tivanis/MicroInverter/Project Outputs for MicroInverter/MicroInverter_BOM.xls

Comment | Description | Designator | Footprint | LibRef | Manufacturer Part Number | Quantity
4u7F, 25V | Capacitor | C1, C2, C3, C27, C28 | 0805 | Cap Semi | 885012107018 | 5
100pF | 885012006036 | C4, C6, C7, C8 | 0603 | Cap Semi | GCM0335C1E101GA16D | 4
100nF, 50V | Capacitor | C5, C9, C10, C17, C18, C19, C20, C23, C24, C26 | 0603 | Cap Semi | C0603C104M5RACTU | 10
82uF, 63V | Capacitor Polarized | C11, C14 | CAP_H10 | Cap Pol | HHXC630ARA820MJA0G | 2
10uF, 63V | Capacitor | C12, C13, C15, C16 | 1210 | Cap Semi | GRM32ER71J106KA12L | 4
47nF, 100V | Capacitor | C21 | 0805 | Cap Semi | CC0805KKX7R0BB473 | 1
1uF, 25V | Capacitor | C22, C25, C29 | 0805 | Cap Semi | VJ0805Y105KXXTW1BC | 3
1uF, 100V | Capacitor | C30, C31 | 0805 | Cap Semi | HMK212BBJ105KG-TE | 2
BAT54S-TP |  | D1, D2, D3, D4 | SOT 23 | BAT54S-TP | BAT54S-TP | 4
RB168MM100TFTR |  | D5 | SOD123 | Diode | RB168MM100TFTR | 1
LED GRN | Typical RED, GREEN, YELLOW, AMBER GaAs LED | DS1 | 0805LED | LED | LTST-S220GKT | 1
CON 3 |  | J1 | CON 3 MOLEX SL | CON 3 SIL Angle | 70553-0002 | 1
CON 6 |  | J2 | CON 6 MOLEX SL | CON 6 SIL Angle | 70553-0040 | 1
CON 10X2 |  | J3, J4 | CON 20 HEADER - (ALT) | CON 10X2 | 68683-305LF | 2
 |  | J5, J6, J7, J8, J9 | CON 1 M3 SCREW | CON 1 Hi Power_Small | Keystone 7771 | 5
6.8uH, 1.6A | Magnetic-Core Inductor | L1 | INDUCTOR - 4x4 mm | Inductor Iron | TYS40306R8M-10 | 1
N-FET |  | Q1, Q2, Q3, Q4, Q5, Q6 | SO-8FL | N-FET | NVMFS6H800NT1G | 6
470k | CR0805-JW-680ELF | R1 | 0805 | Res | CR0805-FX-4703ELF | 1
20k | CR0805-JW-680ELF | R2 | 0805 | Res | CR0805-FX-2002ELF | 1
18k | CR0805-JW-680ELF | R3 | 0805 | Res | CR0805-FX-1802ELF | 1
150Ohm | CR0805-JW-680ELF | R4 | 0805 | Res | CR0805-JW-151ELF | 1
4.7k | CR0805-JW-680ELF | R5, R17, R18, R21 | 0805 | Res | CR0805-FX-4701ELF | 4
2k | CR0805-JW-680ELF | R6, R14, R15, R16, R25 | 0805 | Res | CR0805-FX-2001ELF | 5
3.3k | CR0805-JW-680ELF | R7, R8, R9, R10 | 0805 | Res | CR0805-FX-3301ELF | 4
13k, 1% | CR0805-JW-680ELF | R11, R12, R13 | 0805 | Res | CR0805-FX-1302ELF | 3
200k, 1% | CR0805-JW-680ELF | R19, R20, R26 | 0805 | Res | CR0805-FX-2003ELF | 3
13.3k, 1% | CR0805-JW-680ELF | R22, R23, R24 | 0805 | Res | CR0805-FX-1332ELF | 3
1mOhm | Resistor | R27, R28, R29 | RES TLR2HW CURRENT SENSE | Res | TLR2HWDTE1L00F50 | 3
44.2k, 1% | Resistor | R30, R31, R32, R33 | 0805 | Res | CR0805-FX-4422ELF | 4
39Ohm | Resistor | R34, R35, R36, R37 | 0805 | Res | CR0805-JW-390ELF | 4
2.4k, 1% | Resistor | R38, R39, R40, R41 | 0805 | Res | CR0805-FX-2401ELF | 4
3Ohm | Resistor | R42, R44, R46, R48, R50, R54 | 0805 | Res | SG73P2ATTD3R00F | 6
0Ohm | Resistor | R43, R45, R47, R49, R51 | 0805 | Res | CR0805-J/-000ELF | 5
18kOhm | Resistor | R52, R53 | 0805 | Res | CR0805-FX-1802ELF | 2
1MOhm | Resistor | R55, R56 | 0805 | Res | CR0805-FW-1005ELF | 2
100k | Resistor | R57 | 0805 | Res | CR0805-FX-1003ELF | 1
54.9k, 1% | Resistor | R58 | 0805 | Res | CR0805-FX-5492ELF | 1
10k, 1% | Resistor | R59 | 0805 | Res | CR0805-FX-1003ELF | 1
TC2117-3.3V | Linear regulator | U1 | SOT223 (ZLDO) | 1117 | TC2117-3.3VDBTR | 1
MCP6V26 |  | U2 | SOIC 8-pin | OP_AMP_SINGLE_SOIC | MCP6V26-E/MS | 1
TLC374CDR | Comparator, quad, open drain | U3 | SOIC14 | Comparator Quad | TLC374CDR | 1
INA240 |  | U4, U6 | SOIC 8-pin | INA240 | INA240A2DR | 2
DRV8320RHRHAR | 3f Gate driver 60V | U5 | VQFN-40 | DRV8320RHRHAR | DRV8320RHRHAR | 1
