tivanis/MicroInverter/PDF Schematics and Layout/MicroInverter_Design_Files.pdf

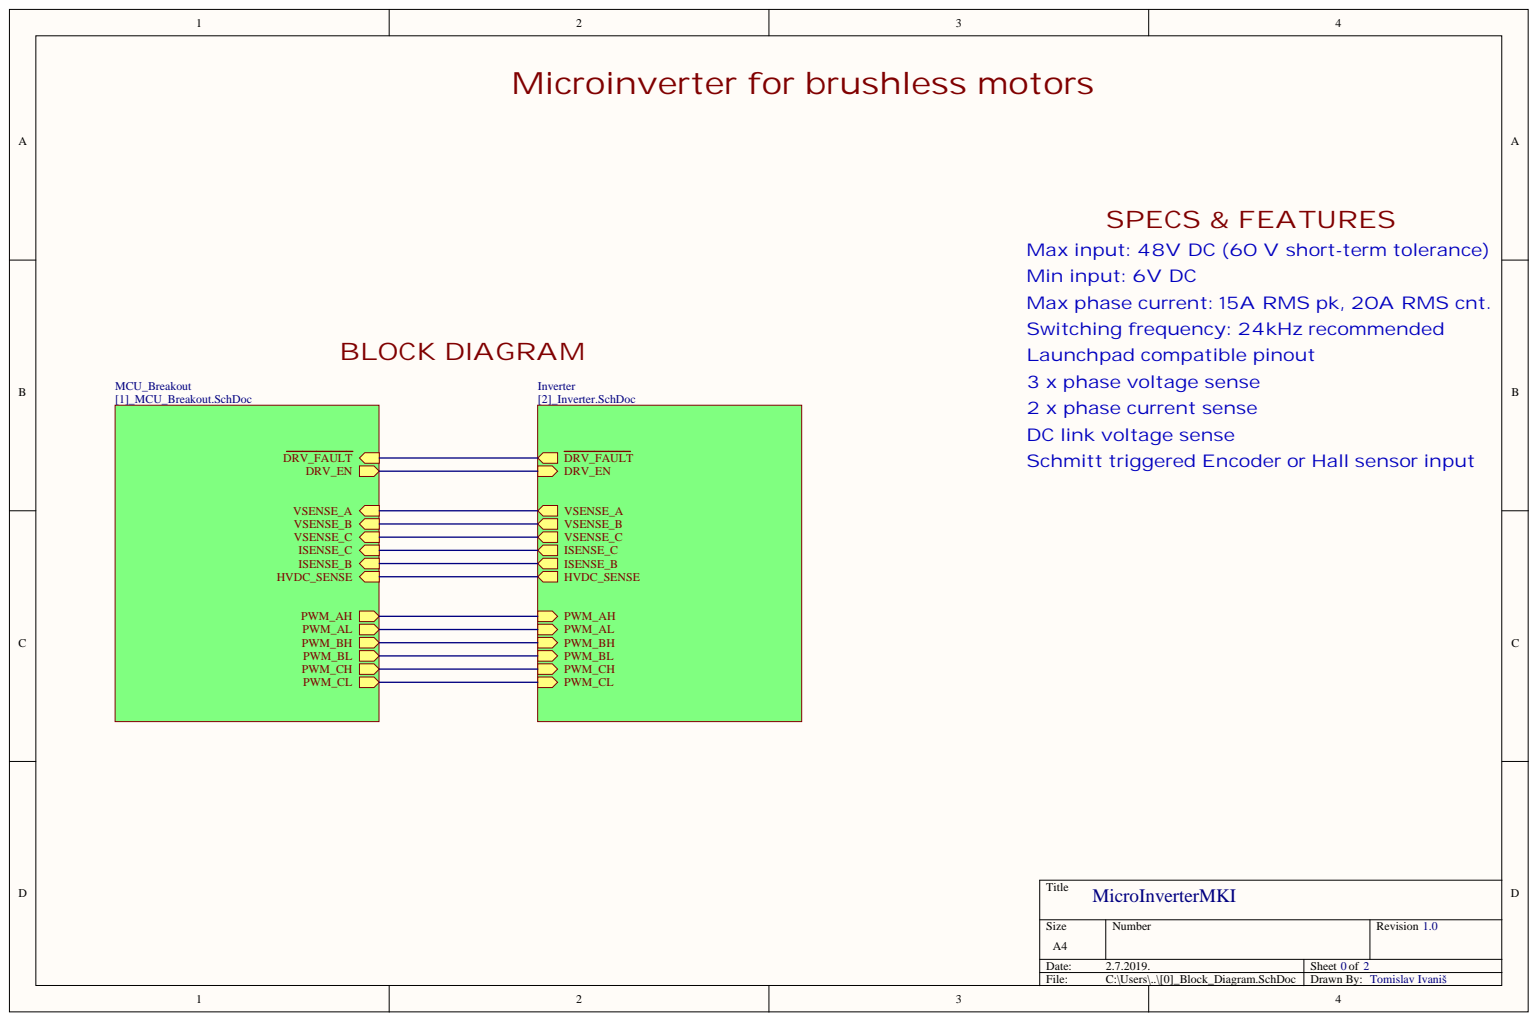
[picture p1: page 1]

Microinverter for brushless motors

Max input: 48V DC (60 V short-term tolerance)
Min input: 6V DC
Max phase current: 15A RMS pk, 20A RMS cnt.
Switching frequency: 24kHz recommended

3 x phase voltage sense
2 x phase current sense
DC link voltage sense
Schmitt triggered Encoder or Hall sensor input

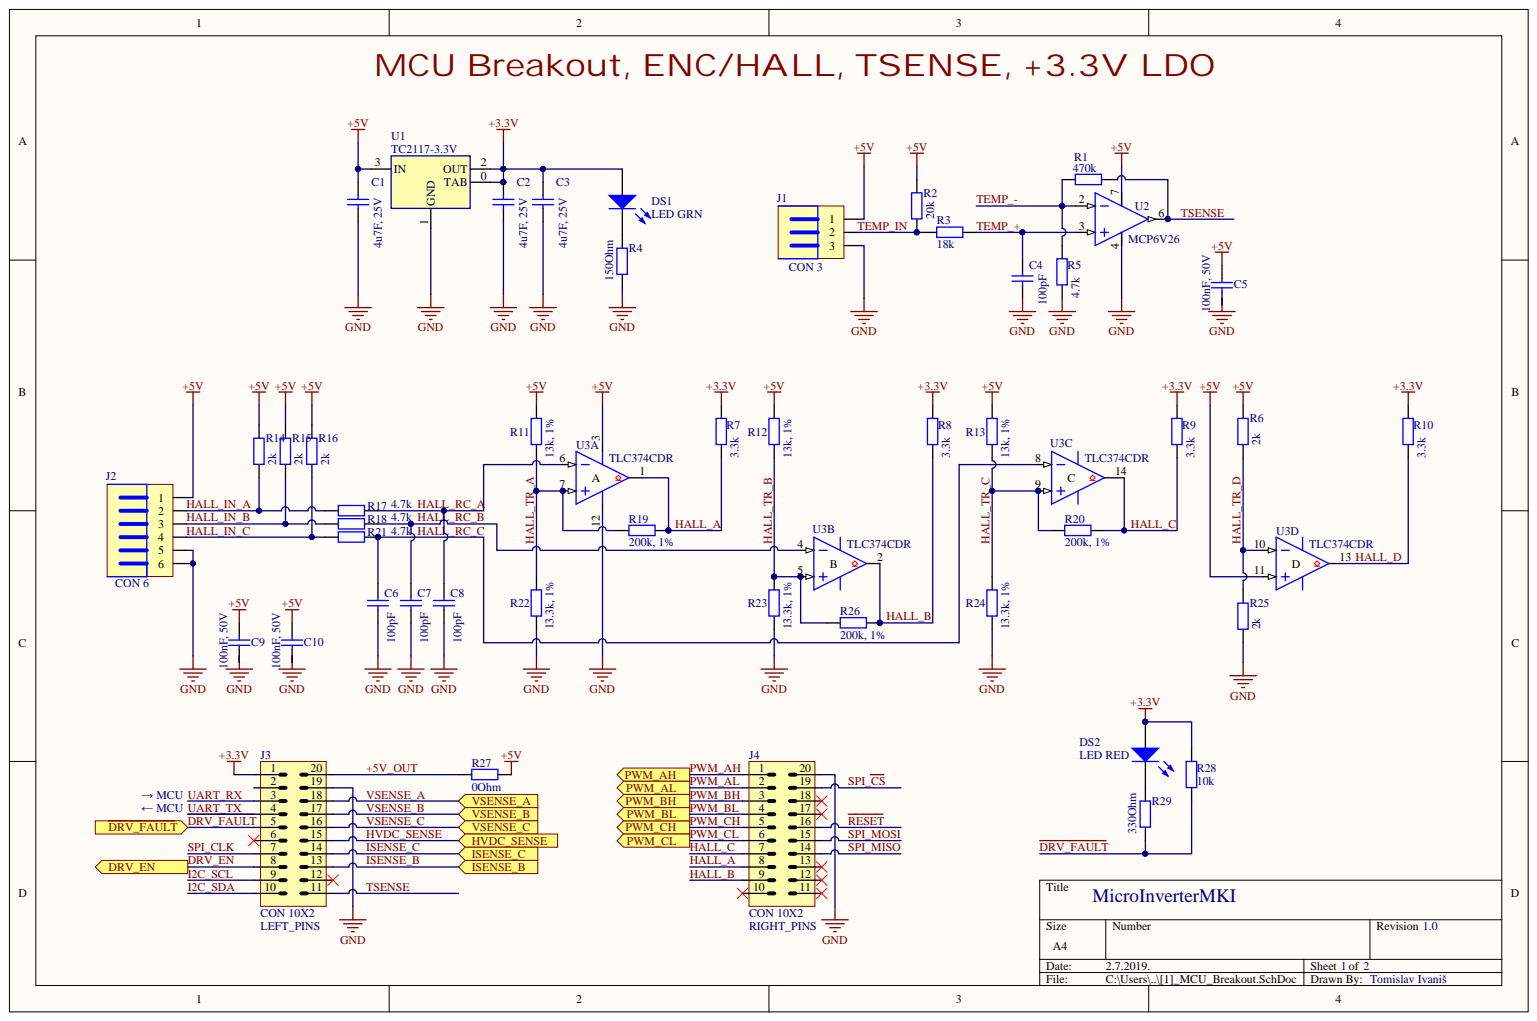
[picture p2: page 2]

MCU Breakout, ENC/HALL, TSENSE, +3.3V LDO

HALL_IN_B | | R18 4.7k HALL_RC_B
HALL_IN_C | R21 4.7k

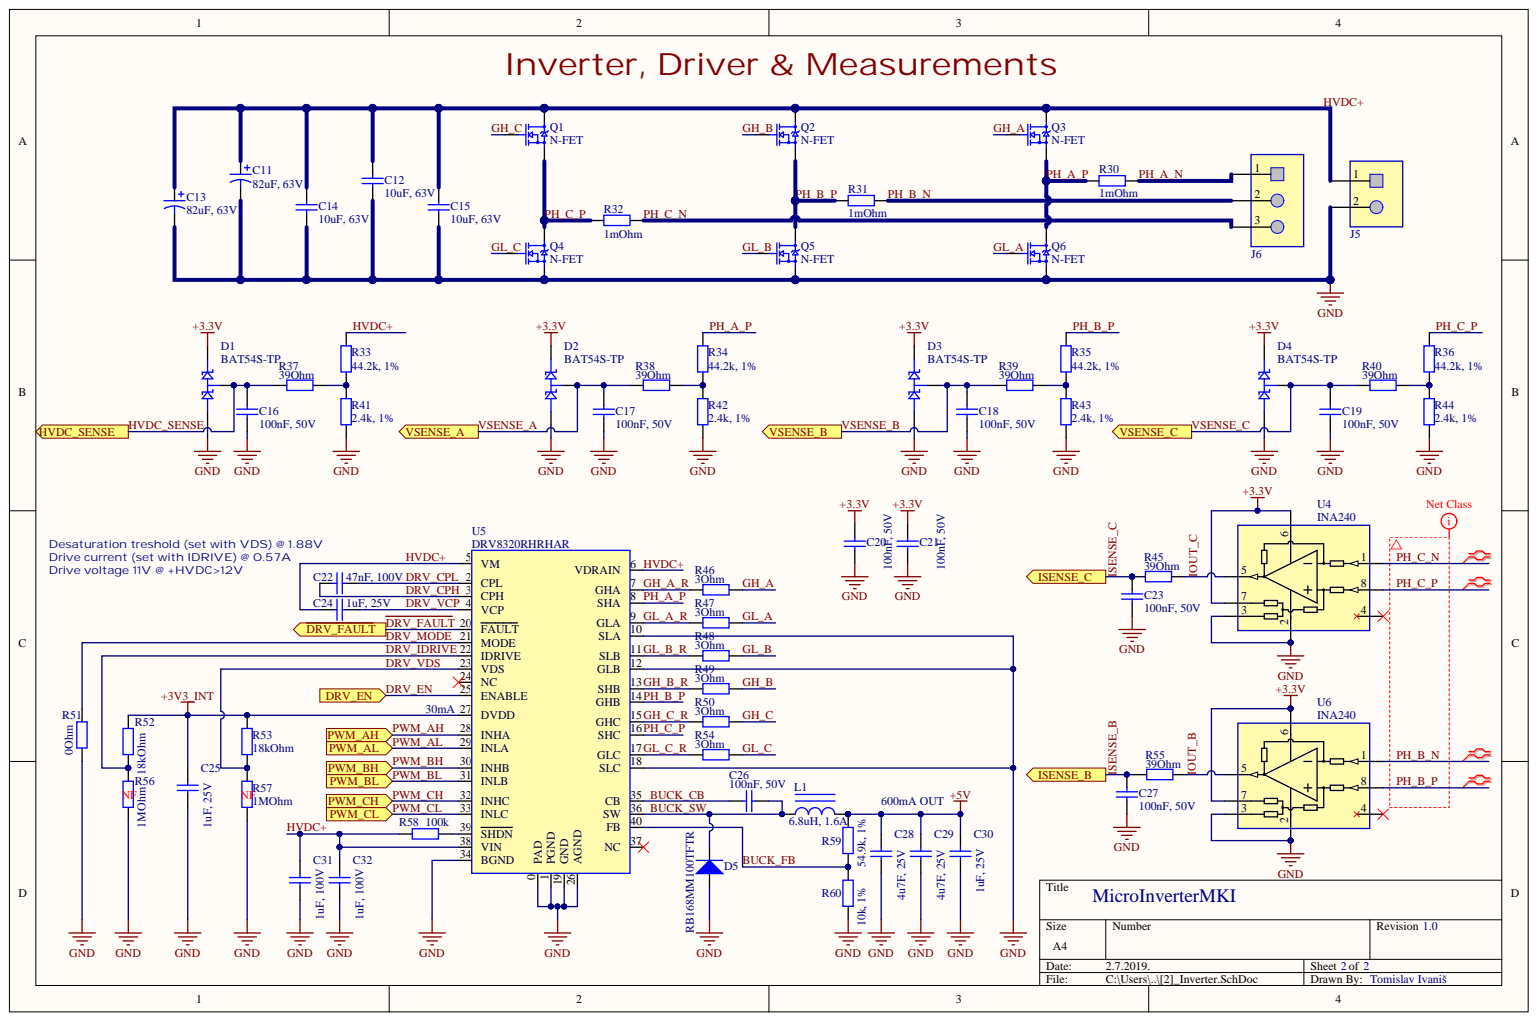
[picture p3: page 3]

Desaturation treshold (set with VDS) @ 1.88V
Drive current (set with IDRIVE) @ 0.57A
Drive voltage 11V @ +HVDC>12V

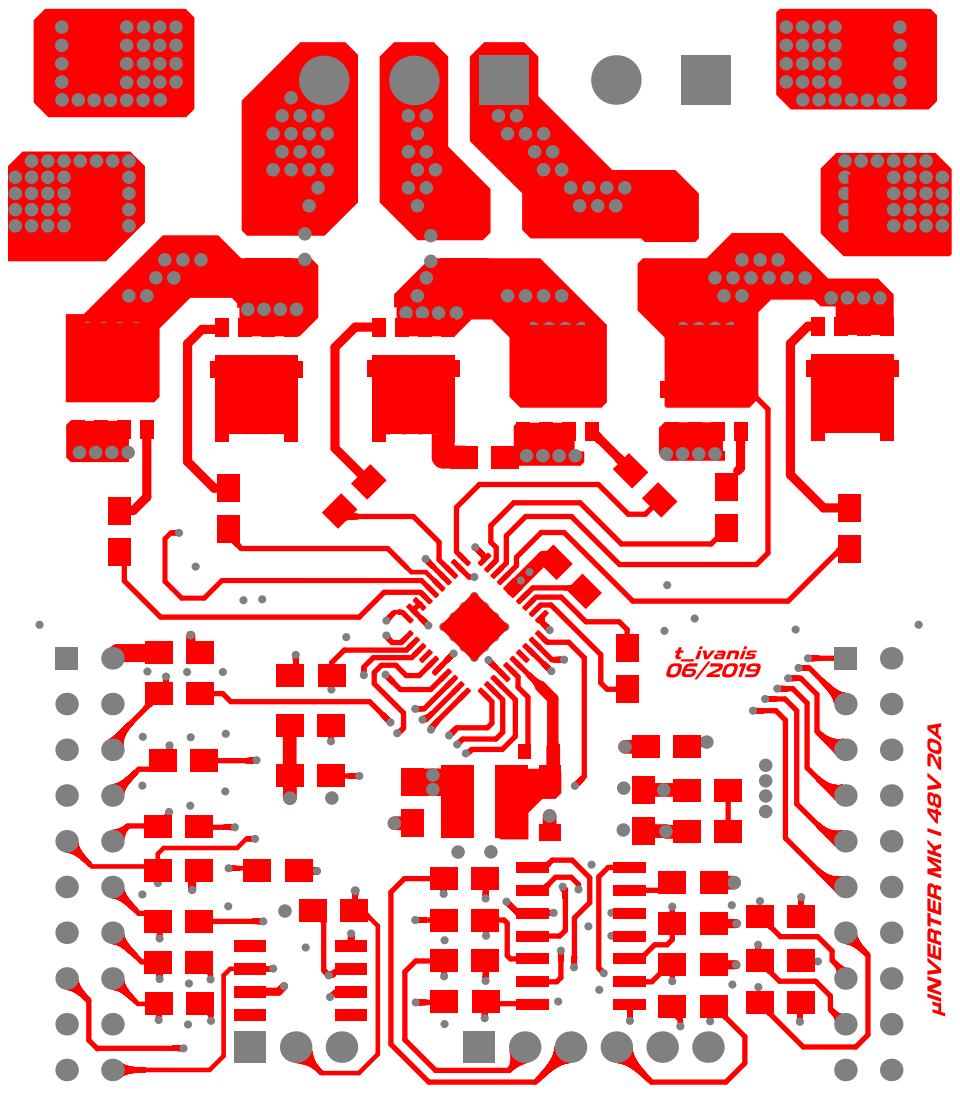
[picture p4: page 4]

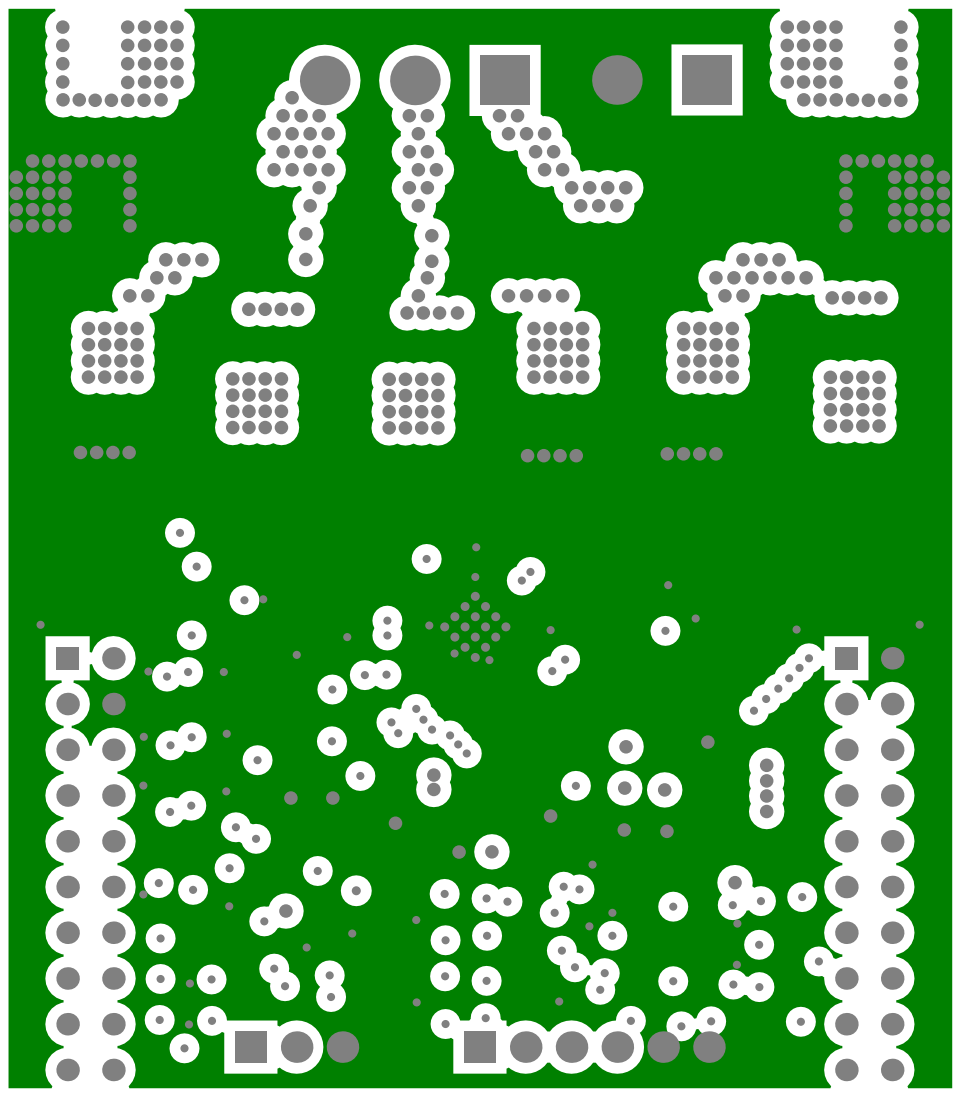
[picture p5: page 5]

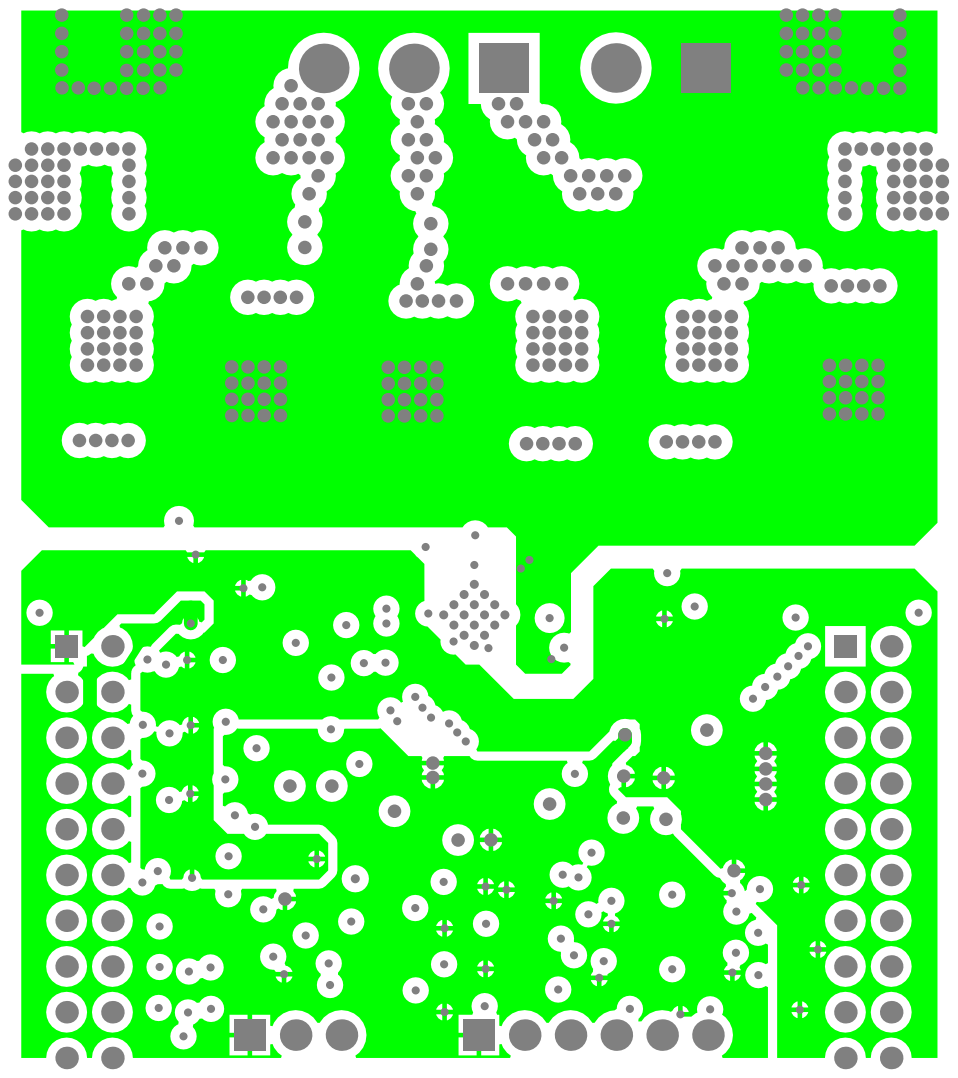
[picture p6: page 6]

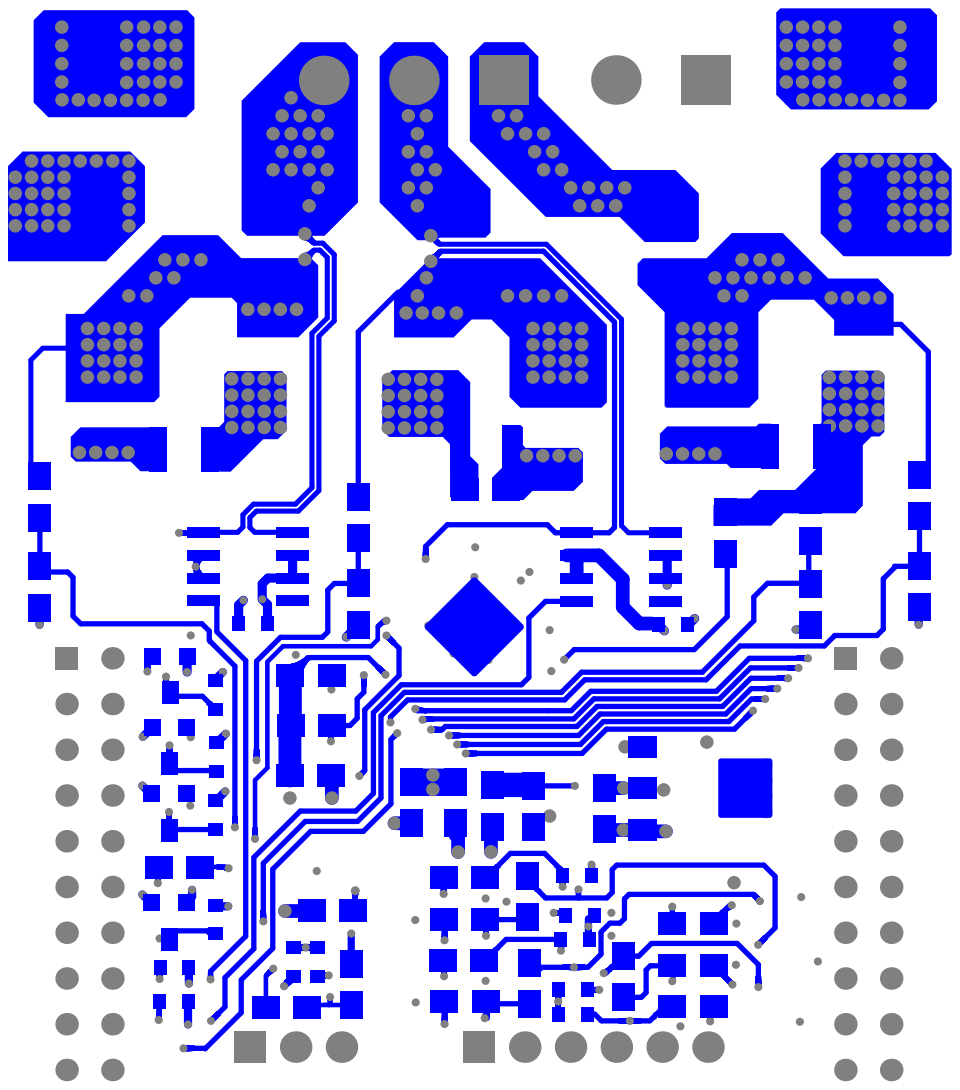
[picture p7: page 7]

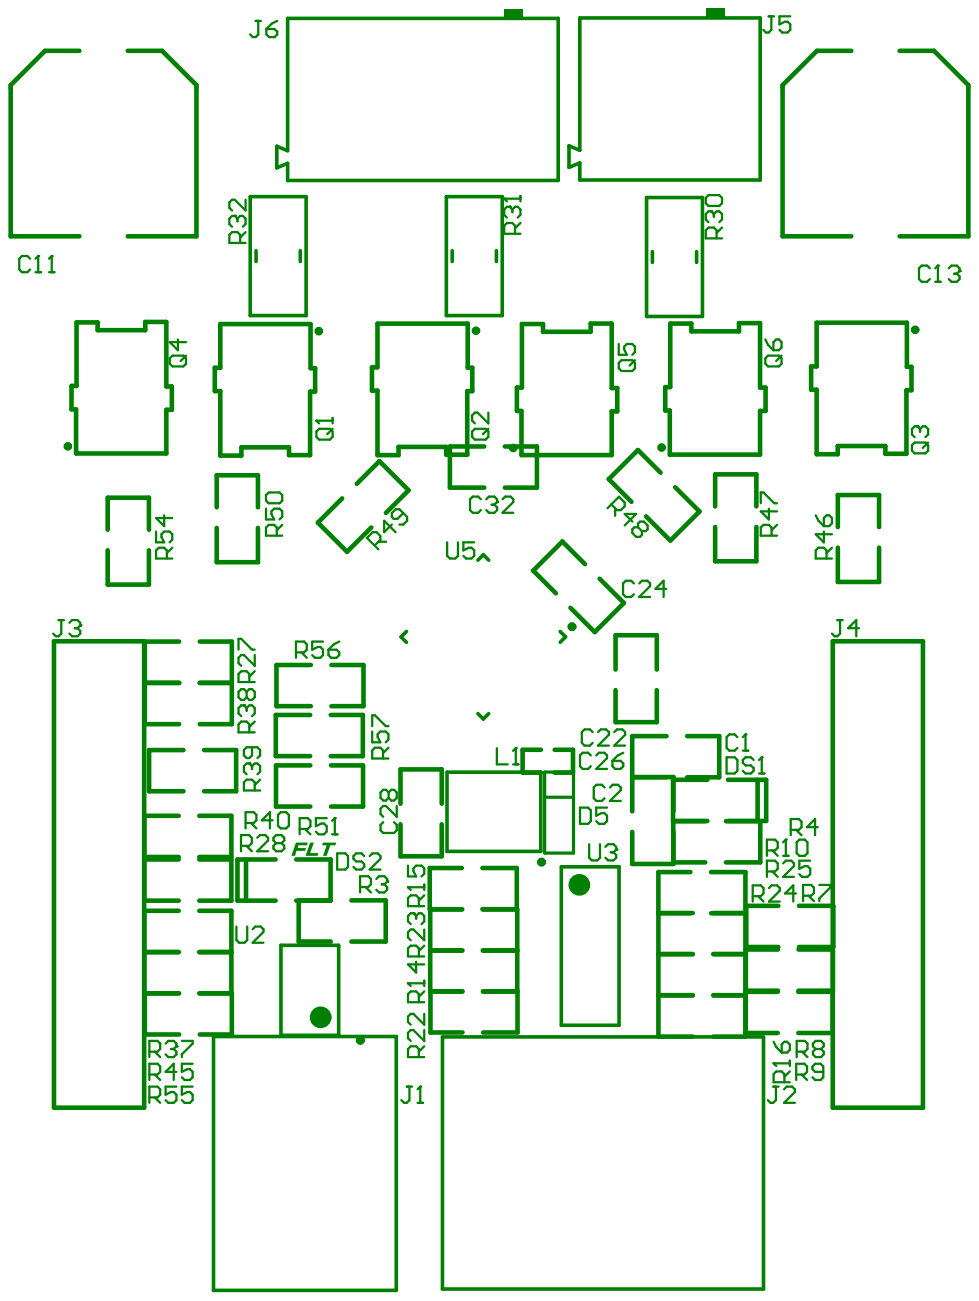
[picture p8: page 8]

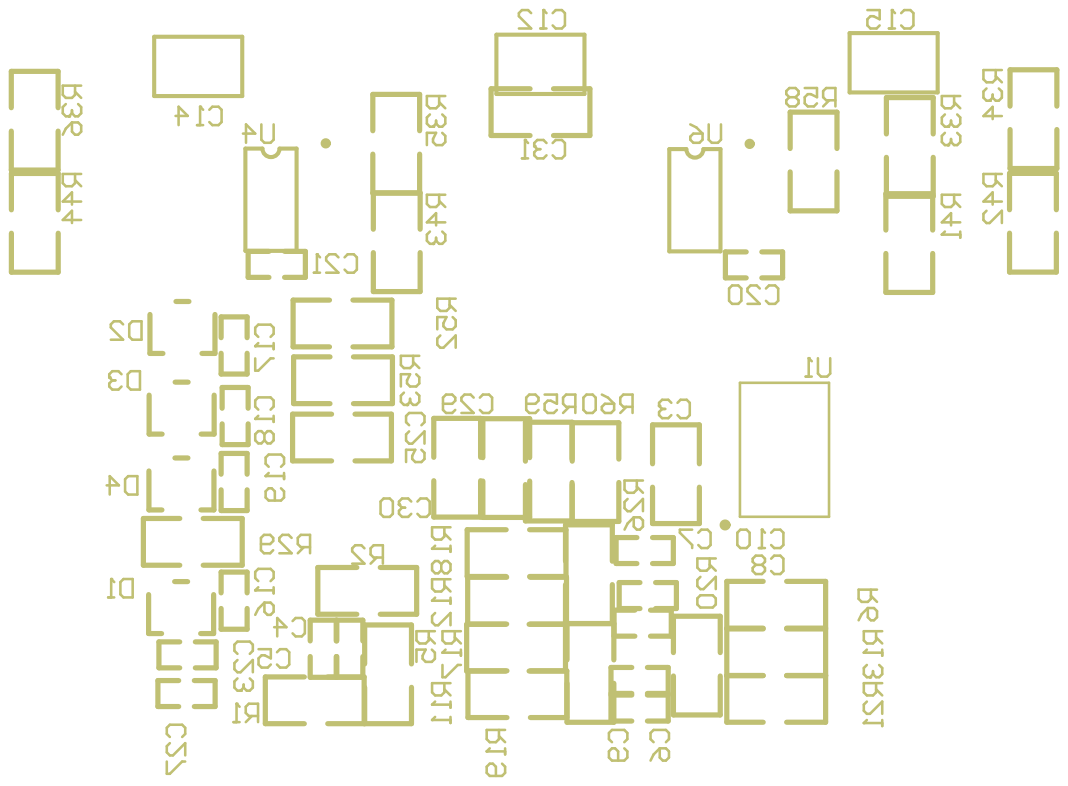
[picture p9: page 9]

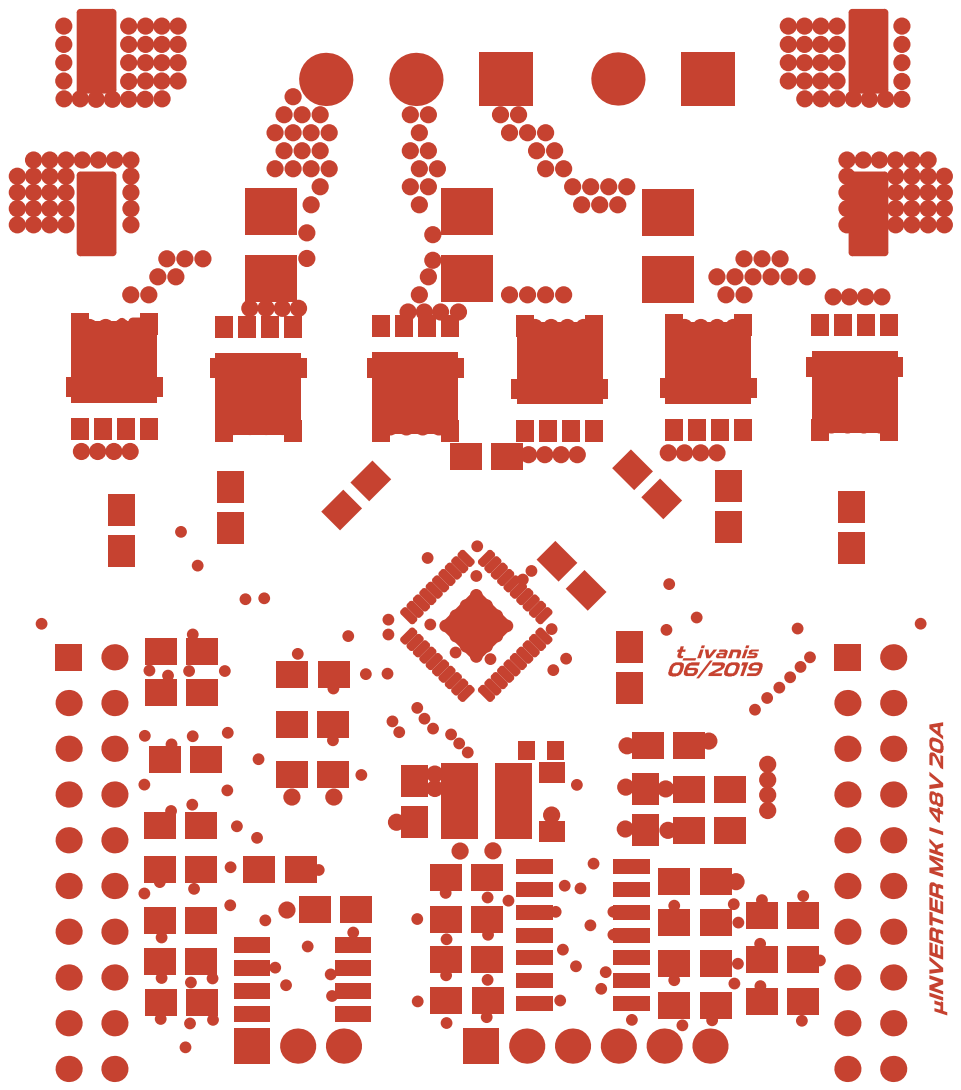
[picture p10: page 12]

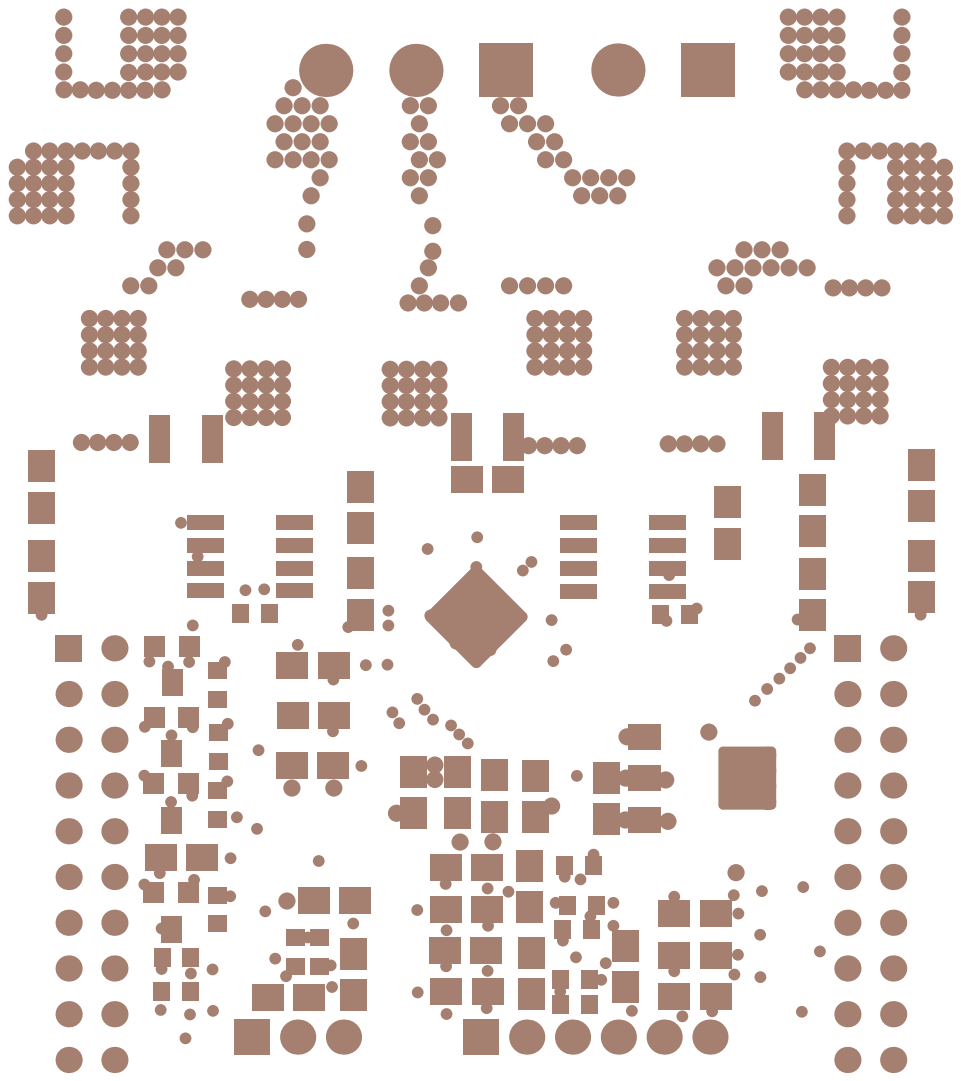
[picture p11: page 13]

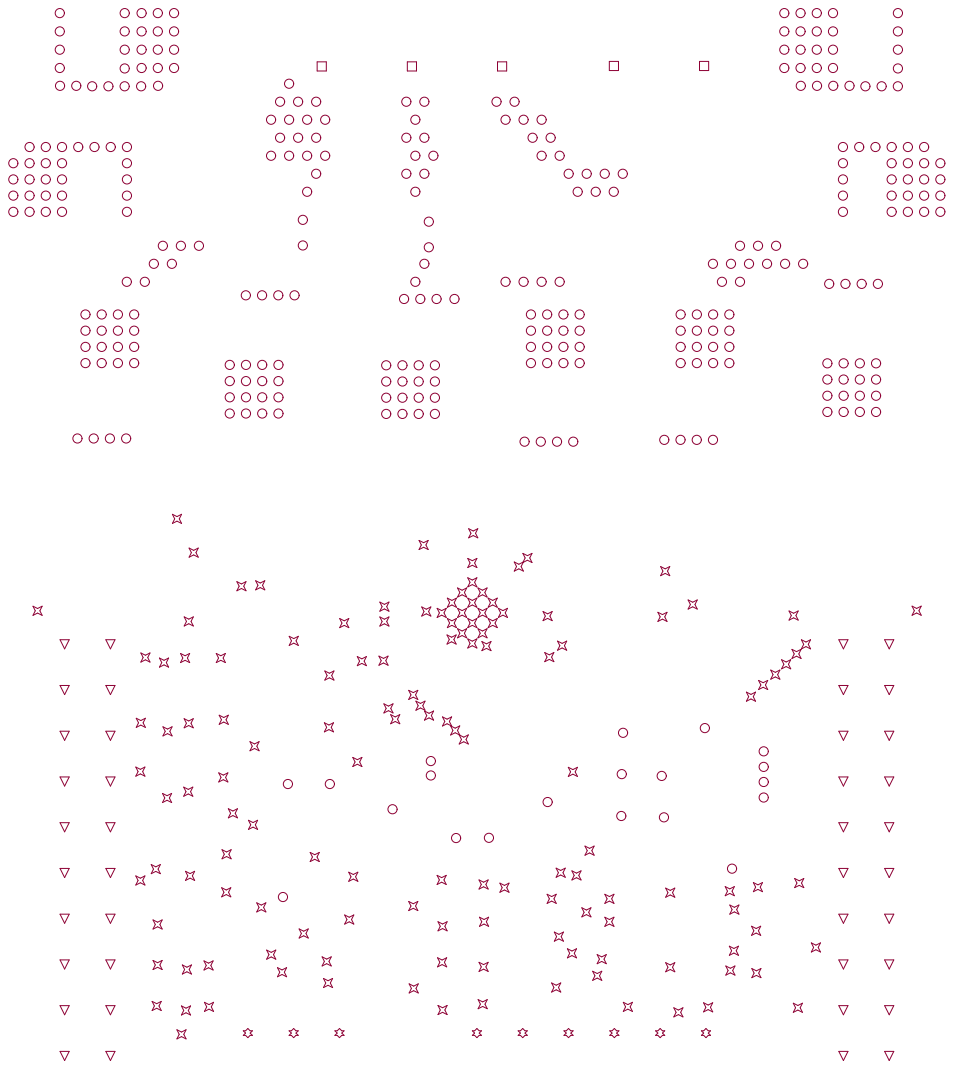
[picture p12: page 19]

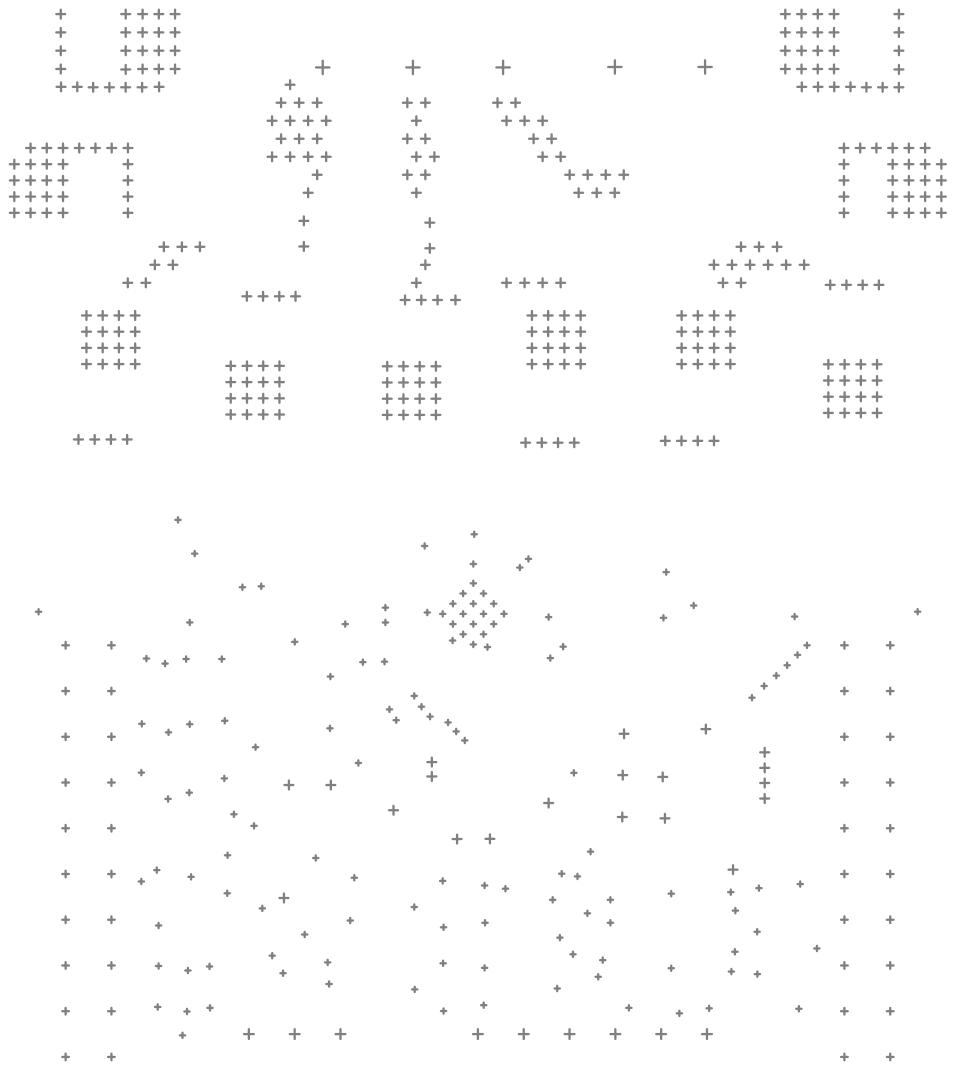
[picture p13: page 20]
