tivanis/MicroInverter/(list of files, drawings)

Other design files:
[0]_Block_Diagram.SchDoc
[1]_MCU_Breakout.SchDoc
[2]_Inverter.SchDoc
MicroInverter.PrjPcb
