tivanis/MicroInverter/(commit log)

2019-06-30 Initial complete project commit
    [MicroInverter.PrjPcb, MicroInverter_BOM.xls, [0]_Block_Diagram.SchDoc, [1]_MCU_Breakout.SchDoc, [2]_Inverter.SchDoc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]
2019-07-01 Fixed schematic titles and pdf output
    [MicroInverter.PrjPcb, [0]_Block_Diagram.SchDoc, [1]_MCU_Breakout.SchDoc, [2]_Inverter.SchDoc]
2019-07-01 Updated gerber and drill files
    [MicroInverter.PrjPcb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]
2019-07-01 Fixed top overlay
    [MicroInverter.PrjPcb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]
2019-07-01 Overlay hotfix
    [uInv_PCB.GBL, uInv_PCB.GBO, uInv_PCB.GBS, uInv_PCB.GM1, uInv_PCB.GTL, uInv_PCB.GTO, uInv_PCB.GTS]
2019-07-01 Minor component allignment fixes
    [uInv_PCB.GBL, uInv_PCB.GBO, uInv_PCB.GBS, uInv_PCB.GM1, uInv_PCB.GTL, uInv_PCB.GTO, uInv_PCB.GTS]
